sharonxrzhu/AirXRP/PCB/airxrp.kicad_pcb

## KiCad design PCB/airxrp.kicad_pcb (2026-08-20)

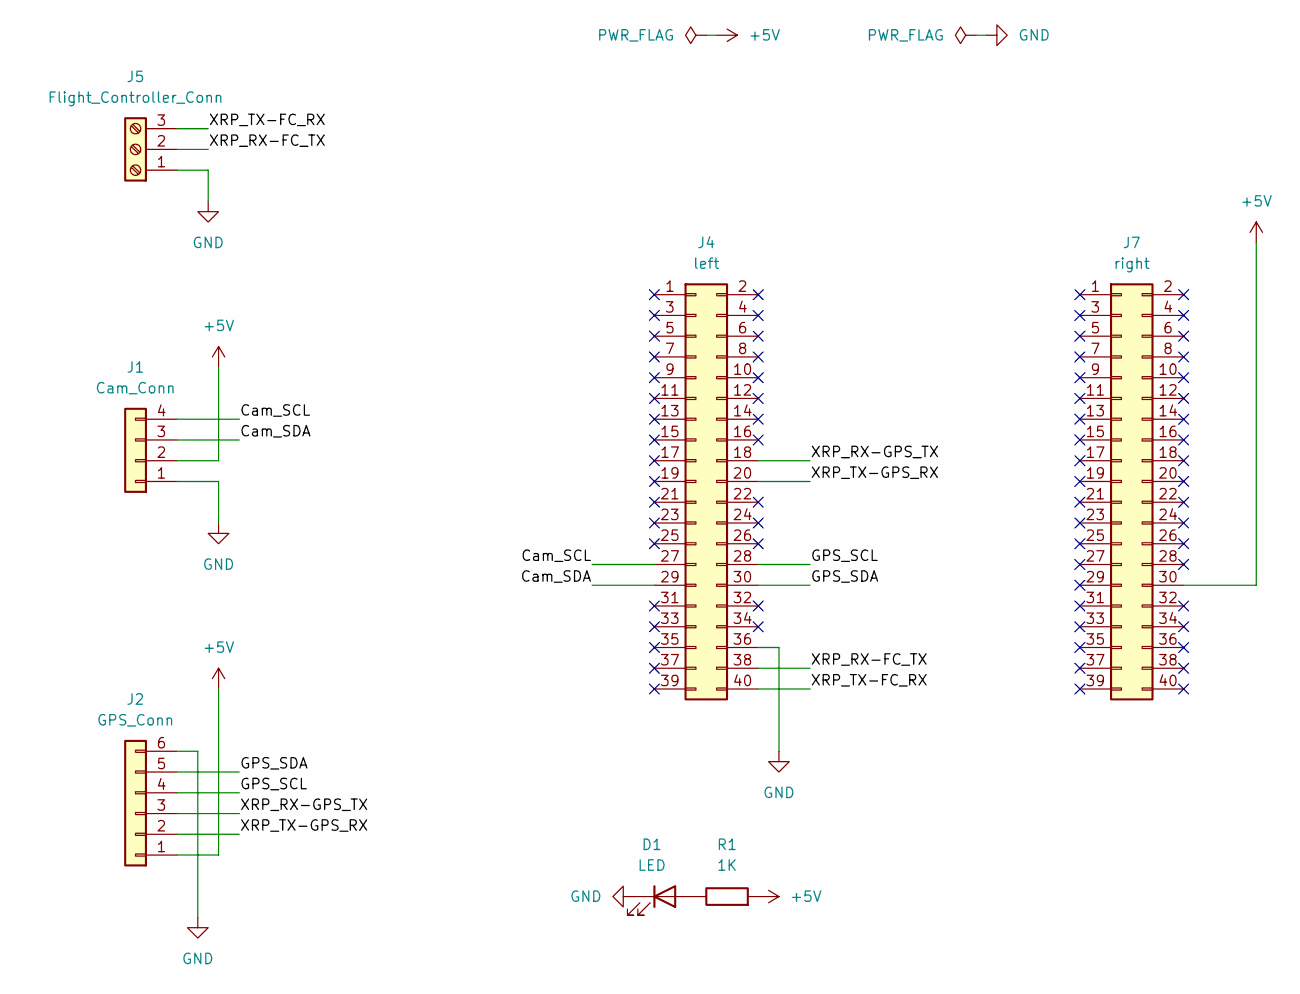
[picture p2: schematic airxrp.kicad_sch]

Parts:
D1: LED; LED_0603_1608Metric
J1: Cam_Conn; TerminalBlock_Phoenix_MPT-0,5-4-2.54_1x04_P2.54mm_Horizontal
J2: GPS_Conn; JST_GH_SM06B-GHS-TB_1x06-1MP_P1.25mm_Horizontal
J4: left; PinHeader_2x20_P2.54mm_Vertical
J5: Flight_Controller_Conn; TerminalBlock_Phoenix_MPT-0,5-3-2.54_1x03_P2.54mm_Horizontal
J7: right; PinHeader_2x20_P2.54mm_Vertical
R1: 1K; R_0603_1608Metric

Connections:
+5V: J1.2, J2.1, J7.30 (Pin_30_30), R1.2
/Cam_SCL: J1.4, J4.27
/Cam_SDA: J1.3, J4.29
/GPS_SCL: J2.4, J4.28
/GPS_SDA: J2.5, J4.30
/XRP_RX-FC_TX: J4.38, J5.2
/XRP_RX-GPS_TX: J2.3, J4.18
/XRP_TX-FC_RX: J4.40, J5.3
/XRP_TX-GPS_RX: J2.2, J4.20
GND: D1.1 (K), J1.1, J2.6, J4.36, J5.1
unnamed: D1.2 (A), R1.1

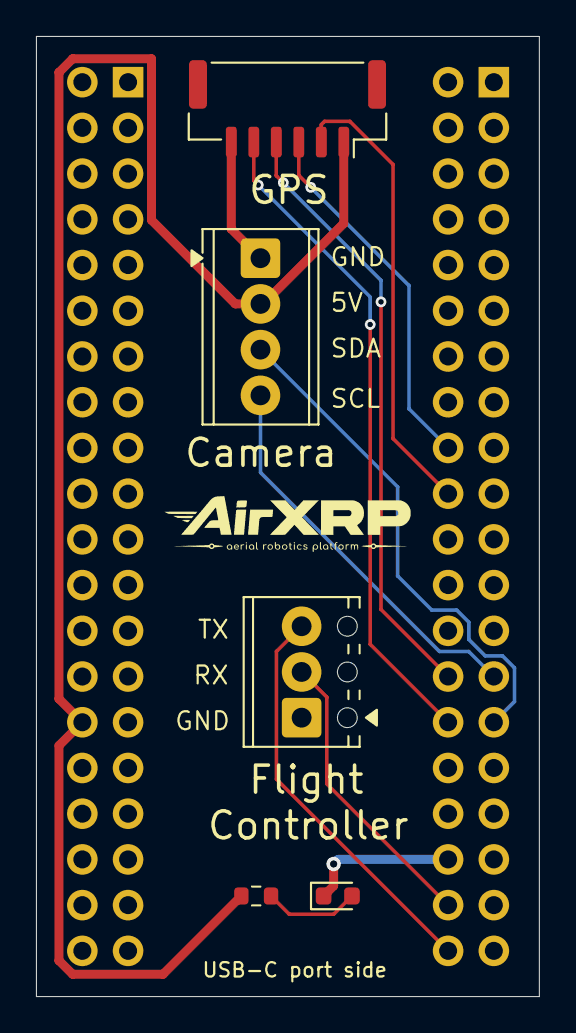
[picture p3: board airxrp.kicad_pcb from above]

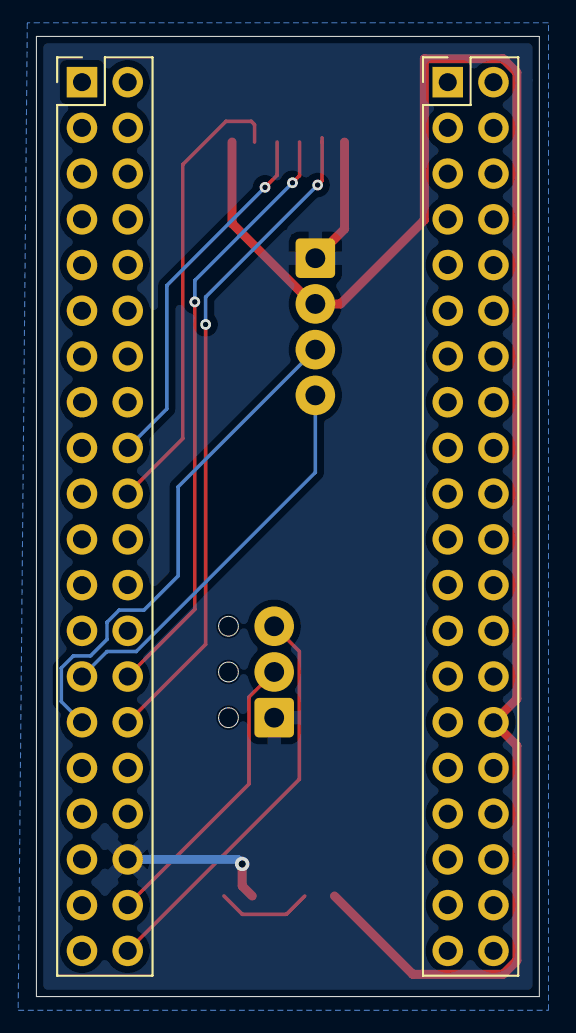
[picture p4: board airxrp.kicad_pcb from below]

Board: 2 copper layers, 27.9 x 53.3 mm, 7 parts (2 on the bottom side), 11 nets.
