sharonxrzhu/AirXRP/(commit log)

2026-07-09 camera initial setup
2026-07-15 Add optical flow script for OpenMV Cam RT1062
2026-08-04 hover
    This file implements a reusable optical-flow hover controller for the AirXRP drone, allowing it to maintain horizontal position based on optical flow data. It includes methods for reading flow data, validating it, and updating the drone's roll and pitch offsets accordingly.
2026-08-14 Add OpenMV optical-flow axis calibration script
2026-08-20 Update hardware assembly link format in README
    Removed HTML anchor tags from hardware assembly link.
2026-08-20 Revise README structure and add user guide
    Updated the README to improve structure and clarity, including a new section for hardware assembly and software user guide.
2026-08-20 Revise README with setup instructions and structure
    Updated the README to include detailed setup instructions for transmitter, Betaflight, and OpenMV camera. Enhanced the structure of chapters and sections for better clarity.
2026-08-20 Revise README sections and add flowchart
    Updated the README to replace 'System Architecture' with 'Import Dependencies Diagram' and added a flowchart illustrating the dependencies.
2026-08-20 Update README with Betaflight switch setup instructions
    Added instructions for setting switches and knobs in Betaflight.
2026-08-20 Update README with troubleshooting information
    Added troubleshooting sections for MSP override and OpenMV camera issues.
